morethegr8/Dishwasher_Controller/hardware/README.md

# SCHEMATIC & HARDWARE 

| |
|---|
|Dishwasher||
|**DISHWASHER IO BOARD**||

Testing & Trial carried out at Raddisson Hotel, Goregoan --> https://www.youtube.com/watch?v=VfFnfKIvYKQ
