morethegr8/Dishwasher_Controller/hardware/IO.pdf

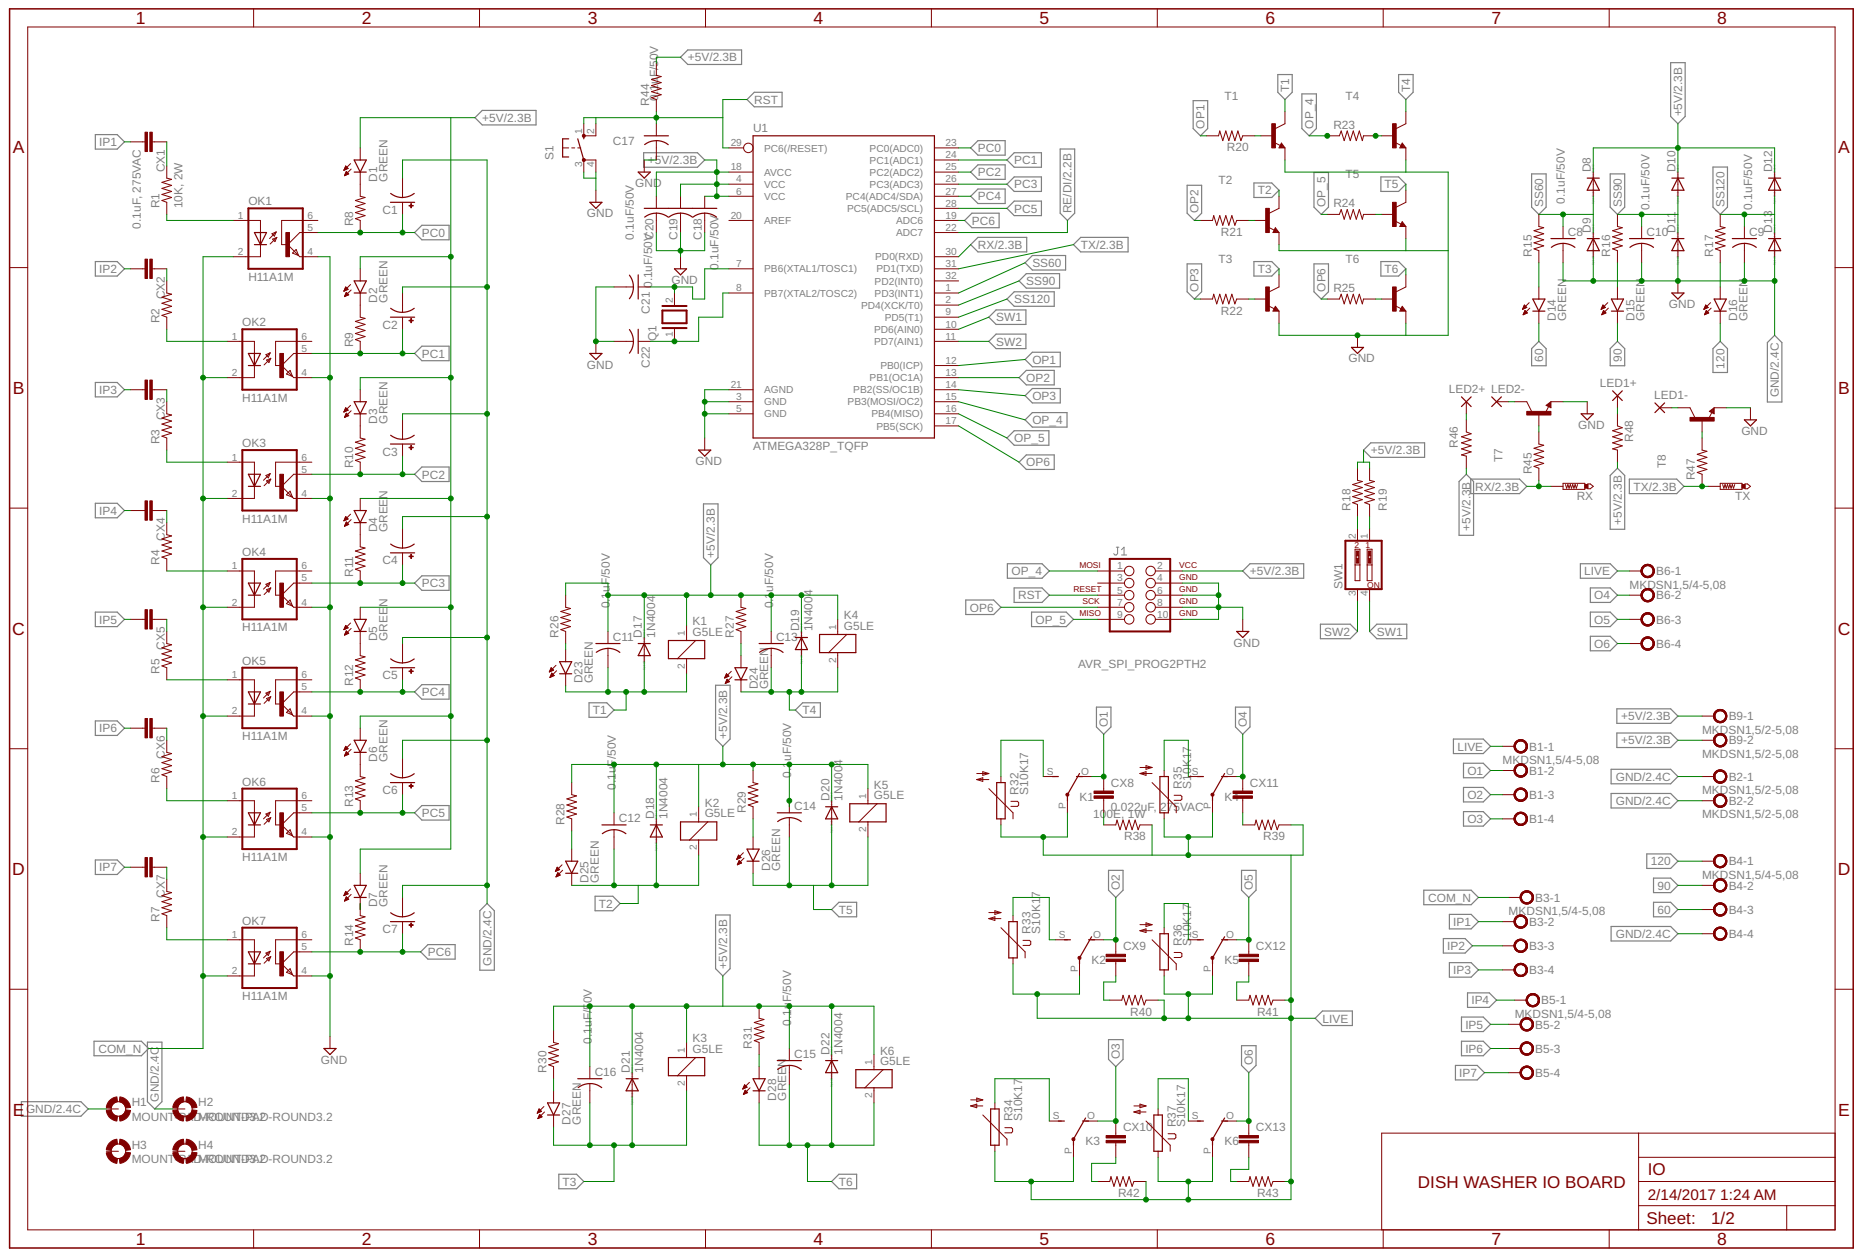
[picture p1: page 1]

GREEN GREEN GREEN GREEN GREEN GREEN GREEN

SpiceOrder 1 SpiceOrder 2

2 1ON MOSI RESET SCK MISO

VCC GND GND GND GND

DISH WASHER IO BOARD

Sheet: 1/2
