morethegr8/Dishwasher_Controller/hardware/IO.sch

## EAGLE design hardware/IO.sch (2018-12-08)

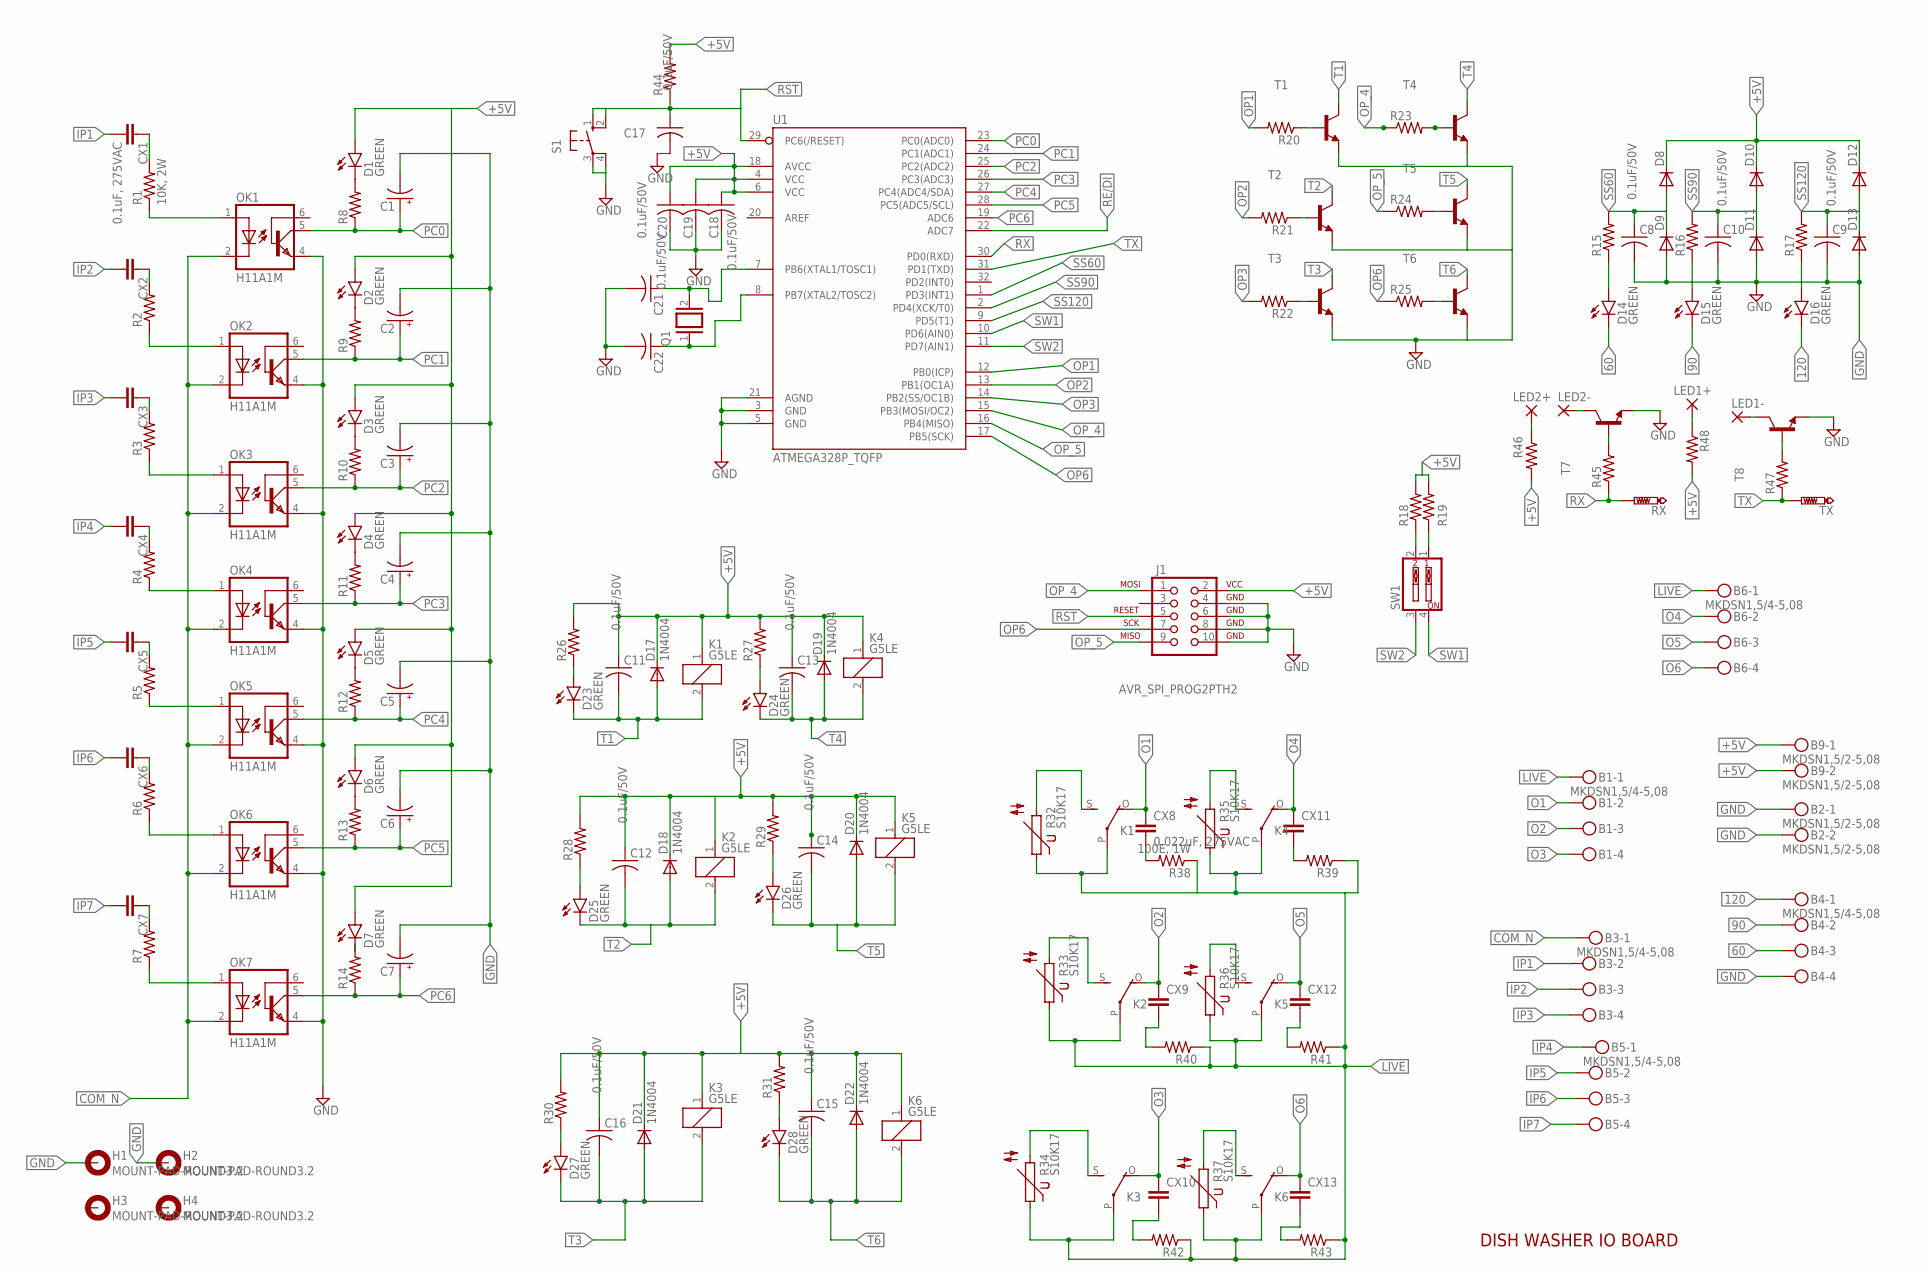
[picture p2: schematic IO.sch, sheet 1]

Parts:
B1, B3, B4, B5, B6: MKDSN1,5/4-5,08
B2, B9: MKDSN1,5/2-5,08
C1, C2, C3, C4, C5, C6, C7: CPOL-USSMCC; SMC_C
C8, C9, C10, C11, C12, C13, C14, C15, C16, C17, C18, C19, C20: 0.1uF/50V; C0805K
C21, C22: C-USC0603K; C0603K
CX1: 0.1uF, 275VAC; XC15B8
CX2, CX3, CX4, CX5, CX6, CX7: CXXC15B8; XC15B8
CX8: 0.022uF, 275VAC; XC10B5
CX9, CX10, CX11, CX12, CX13: CXXC10B5; XC10B5
D1, D2, D3, D4, D5, D6, D7, D14, D15, D16, D23, D24, D25, D26, D27, D28: GREEN; LED-1206
D8, D9, D10, D11, D12, D13: 1N4148DO35-10; DO35-10
D17, D18, D19, D20, D21, D22: 1N4004; DO41-10
H1, H2, H3, H4: MOUNT-PAD-ROUND3.2; 3,2-PAD
J1: AVR_SPI_PROG2PTH2; 2X5-SHROUDED
K1, K2, K3, K4, K5, K6: G5LE
LED1+, LED1-, LED2+, LED2-: 2,54/1,0
OK1, OK2, OK3, OK4, OK5, OK6, OK7: H11A1M; DIL06
Q1: XTAL/S; QS
R1: 10K, 2W; 0617/22
R2, R3, R4, R5, R6, R7: R-US_0617/22; 0617/22
R8, R9, R10, R11, R12, R13, R14, R15, R16, R17, R18, R19, R20, R21, R22, R23, R24, R25, R26, R27, R28, R29, R30, R31, R44, R45, R46, R47, R48: R-US_R0805; R0805
R32, R33, R34, R35, R36, R37: S10K17
R38: 100E, 1W; 0411/15
R39, R40, R41, R42, R43: R-US_0411/15; 0411/15
RX: PTR1B1,27; B1,27
S1: 10-XX; B3F-10XX
SW1: SW_DIP-2; EDG-02
T1, T2, T3, T4, T5, T6, T7, T8: MMBT2222ALT1-NPN-SOT23-BEC; SOT23-BEC
TX: PTR1B1,27; B1,27
U1: ATMEGA328P_TQFP; TQFP32-08

Connections:
60: B4.3, D14.C
90: B4.2, D15.C
120: B4.1, D16.C
+5V: B9.1, B9.2, C11.1, C12.1, C13.1, C14.1, C15.1, C16.1, C18.1, C19.1, C20.1, D1.A, D2.A, D3.A, D4.A, D5.A, D6.A, D7.A, D8.C, D10.C, D12.C, D17.C, D18.C, D19.C, D20.C, D21.C, D22.C, J1.2 (VCC), K1.1, K2.1, K3.1, K4.1, K5.1, K6.1, R18.2, R19.2, R26.2, R27.2, R28.2, R29.2, R30.2, R31.2, R44.2, R46.2, R48.2, U1.4 (VCC), U1.6 (VCC), U1.18 (AVCC)
COM_N: B3.1, OK1.2 (C), OK2.2 (C), OK3.2 (C), OK4.2 (C), OK5.2 (C), OK6.2 (C), OK7.2 (C)
GND: B2.1, B2.2, B4.4, C1.-, C2.-, C3.-, C4.-, C5.-, C6.-, C7.-, C8.2, C9.2, C10.2, C17.2, C18.2, C19.2, C20.2, C21.2, C22.2, D9.A, D11.A, D13.A, H1.B3,2, H2.B3,2, J1.4 (GND), J1.6 (GND), J1.8 (GND), J1.10 (GND), OK1.4 (EMI), OK2.4 (EMI), OK3.4 (EMI), OK4.4 (EMI), OK5.4 (EMI), OK6.4 (EMI), OK7.4 (EMI), S1.3, S1.4 (P1), T1.E, T2.E, T3.E, T4.E, T5.E, T6.E, T7.E, T8.E, U1.3 (GND), U1.5 (GND), U1.21 (AGND)
IP1: B3.2, CX1.2
IP2: B3.3, CX2.2
IP3: B3.4, CX3.2
IP4: B5.1, CX4.2
IP5: B5.2, CX5.2
IP6: B5.3, CX6.2
IP7: B5.4, CX7.2
LIVE: B1.1, B6.1, K1.P, K2.P, K3.P, K4.P, K5.P, K6.P, R32.1, R33.1, R34.1, R35.1, R36.1, R37.1, R38.1, R39.1, R40.1, R41.1, R42.1, R43.1
unnamed: OK1.1 (A), R1.1
unnamed: CX1.1, R1.2
unnamed: CX2.1, R2.2
unnamed: OK2.1 (A), R2.1
unnamed: CX3.1, R3.2
unnamed: OK3.1 (A), R3.1
unnamed: CX4.1, R4.2
unnamed: OK4.1 (A), R4.1
unnamed: CX5.1, R5.2
unnamed: CX6.1, R6.2
unnamed: OK5.1 (A), R5.1
unnamed: OK6.1 (A), R6.1
unnamed: CX7.1, R7.2
unnamed: OK7.1 (A), R7.1
unnamed: D1.C, R8.2
unnamed: D2.C, R9.2
unnamed: D3.C, R10.2
unnamed: D4.C, R11.2
unnamed: D5.C, R12.2
unnamed: D6.C, R13.2
unnamed: D7.C, R14.2
unnamed: R45.2, T7.B
unnamed: R47.2, T8.B
unnamed: R20.1, T1.B
unnamed: LED2+.1, R46.1
unnamed: R18.1, SW1.2
unnamed: R19.1, SW1.1
unnamed: R21.1, T2.B
unnamed: D14.A, R15.1
unnamed: D15.A, R16.1
unnamed: D16.A, R17.1
unnamed: R22.1, T3.B
unnamed: R23.2, T4.B
unnamed: R24.2, T5.B
unnamed: R25.2, T6.B
unnamed: LED2-.1, T7.C
unnamed: D27.A, R30.1
unnamed: D23.A, R26.1
unnamed: K1.S, R32.2
unnamed: CX8.2, R38.2
unnamed: D24.A, R27.1
unnamed: D26.A, R29.1
unnamed: D25.A, R28.1
unnamed: K4.S, R35.2
unnamed: CX11.2, R39.2
unnamed: K2.S, R33.2
unnamed: D28.A, R31.1
unnamed: CX9.2, R40.2
unnamed: CX12.2, R41.2
unnamed: K5.S, R36.2
unnamed: CX10.2, R42.2
unnamed: K3.S, R34.2
unnamed: CX13.2, R43.2
unnamed: K6.S, R37.2
unnamed: C21.1, Q1.2, U1.7 (PB6(XTAL1/TOSC1))
unnamed: LED1+.1, R48.1
unnamed: C22.1, Q1.1, U1.8 (PB7(XTAL2/TOSC2))
unnamed: LED1-.1, T8.C
O1: B1.2, CX8.1, K1.O
O2: B1.3, CX9.1, K2.O
O3: B1.4, CX10.1, K3.O
O4: B6.2, CX11.1, K4.O
O5: B6.3, CX12.1, K5.O
O6: B6.4, CX13.1, K6.O
OP1: R20.2, U1.12 (PB0(ICP))
OP2: R21.2, U1.13 (PB1(OC1A))
OP3: R22.2, U1.14 (PB2(SS/OC1B))
OP6: J1.7 (SCK), R25.1, U1.17 (PB5(SCK))
OP_4: J1.1 (MOSI), R23.1, U1.15 (PB3(MOSI/OC2))
OP_5: J1.9 (MISO), R24.1, U1.16 (PB4(MISO))
PC0: C1.+, OK1.5 (COL), R8.1, U1.23 (PC0(ADC0))
PC1: C2.+, OK2.5 (COL), R9.1, U1.24 (PC1(ADC1))
PC2: C3.+, OK3.5 (COL), R10.1, U1.25 (PC2(ADC2))
PC3: C4.+, OK4.5 (COL), R11.1, U1.26 (PC3(ADC3))
PC4: C5.+, OK5.5 (COL), R12.1, U1.27 (PC4(ADC4/SDA))
PC5: C6.+, OK6.5 (COL), R13.1, U1.28 (PC5(ADC5/SCL))
PC6: C7.+, OK7.5 (COL), R14.1, U1.19 (ADC6)
RE/DI: U1.22 (ADC7)
RST: C17.1, J1.5 (RESET), R44.1, S1.1 (S), S1.2 (S1), U1.29 (PC6(/RESET))
RX: R45.1, RX.TP, U1.30 (PD0(RXD))
SS60: C8.1, D8.A, D9.C, R15.2, U1.1 (PD3(INT1))
SS90: C10.1, D10.A, D11.C, R16.2, U1.2 (PD4(XCK/T0))
SS120: C9.1, D12.A, D13.C, R17.2, U1.9 (PD5(T1))
SW1: SW1.4, U1.10 (PD6(AIN0))
SW2: SW1.3, U1.11 (PD7(AIN1))
T1: C11.2, D17.A, D23.C, K1.2, T1.C
T2: C12.2, D18.A, D25.C, K2.2, T2.C
T3: C16.2, D21.A, D27.C, K3.2, T3.C
T4: C13.2, D19.A, D24.C, K4.2, T4.C
T5: C14.2, D20.A, D26.C, K5.2, T5.C
T6: C15.2, D22.A, D28.C, K6.2, T6.C
TX: R47.1, TX.TP, U1.31 (PD1(TXD))

Notes on the sheet:
DISH WASHER IO BOARD

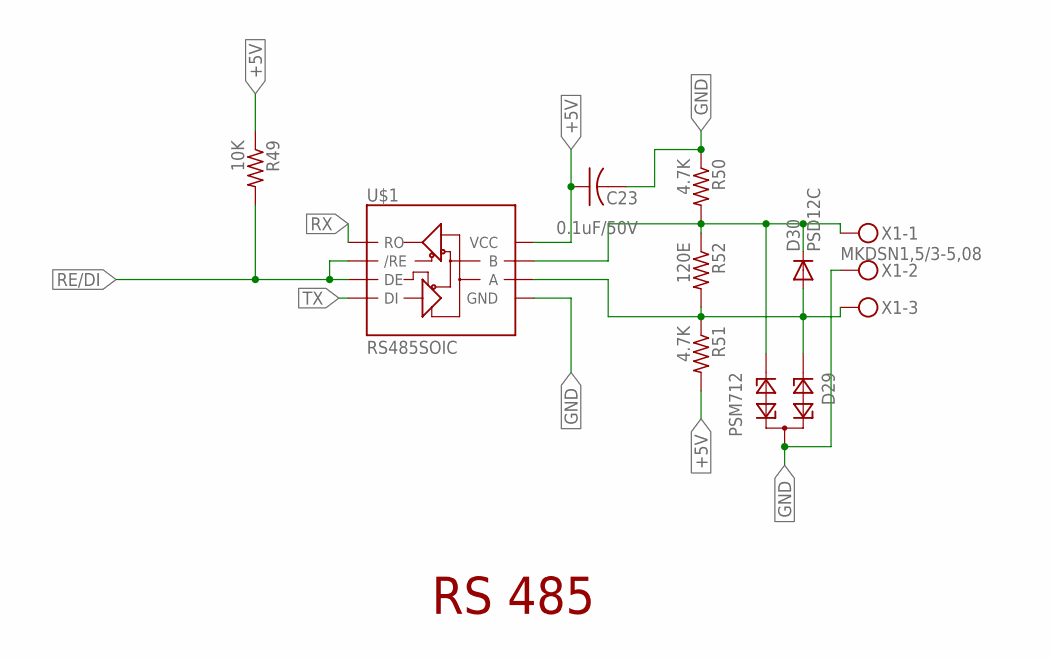
[picture p3: schematic IO.sch, sheet 2]

Parts:
C23: 0.1uF/50V; C0805K
D29: PSM712; SOT23
D30: PSD12C; SMA
R49: 10K; R0603
R50, R51: 4.7K; R0603
R52: 120E; R0805
U$1: RS485SOIC; SO08
X1: MKDSN1,5/3-5,08

Connections:
+5V: C23.1, R49.1, R51.2, U$1.8 (VCC)
GND: C23.2, D29.3, R50.1, U$1.5 (GND), X1.2
unnamed: D29.2, D30.C, R50.2, R52.1, U$1.7 (B), X1.1
unnamed: D29.1, D30.A, R51.1, R52.2, U$1.6 (A), X1.3
RE/DI: R49.2, U$1.2 (/RE), U$1.3 (DE)
RX: U$1.1 (RO)
TX: U$1.4 (DI)

Notes on the sheet:
RS 485
