morethegr8/Dishwasher_Controller/code/src/driver_init.c

/**
 * \file
 *
 * \brief Driver initialization.
 *
 *
 * Copyright (C) 2016 Atmel Corporation. All rights reserved.
 *
 * \asf_license_start
 *
 * \page License
 *
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
 * 3. The name of Atmel may not be used to endorse or promote products derived
 *    from this software without specific prior written permission.
 *
 * 4. This software may only be redistributed and used in connection with an
 *    Atmel microcontroller product.
 *
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
 * \asf_license_stop
 *
 *
 */

/*
 * Code generated by START.
 *
 * This file will be overwritten when reconfiguring your START project.
 * Please copy examples or other code you want to keep to a separate file
 * to avoid losing it when reconfiguring.
 */

#include "driver_init.h"
#include <system.h>

void TIMER_0_initialization(void)
{

	TIMER_0_init();
}

/* configure pins and initialize registers */
void USART_0_initialization(void)
{

	// Set pin direction to input
	PD0_set_dir(PORT_DIR_IN);

	PD0_set_pull_mode(
	    // <y> Pull configuration
	    // <id> pad_pull_config
	    // <PORT_PULL_OFF"> Off
	    // <PORT_PULL_UP"> Pull-up
	    PORT_PULL_OFF);

	// Set pin direction to output
	PD1_set_dir(PORT_DIR_OUT);

	PD1_set_level(
	    // <y> Initial level
	    // <id> pad_initial_level
	    // <false"> Low
	    // <true"> High
	    false);

	USART_0_init();
}

void system_init()
{
	mcu_init();

	/* PORT setting on PB0 */

	// Set pin direction to output
	Wash_Pump_set_dir(PORT_DIR_OUT);

	Wash_Pump_set_level(
	    // <y> Initial level
	    // <id> pad_initial_level
	    // <false"> Low
	    // <true"> High
	    false);

	/* PORT setting on PB1 */

	// Set pin direction to output
	Rinse_Pump_set_dir(PORT_DIR_OUT);

	Rinse_Pump_set_level(
	    // <y> Initial level
	    // <id> pad_initial_level
	    // <false"> Low
	    // <true"> High
	    false);

	/* PORT setting on PB2 */

	// Set pin direction to output
	Fill_set_dir(PORT_DIR_OUT);

	Fill_set_level(
	    // <y> Initial level
	    // <id> pad_initial_level
	    // <false"> Low
	    // <true"> High
	    false);

	/* PORT setting on PB3 */

	// Set pin direction to output
	Tank_Heater_set_dir(PORT_DIR_OUT);

	Tank_Heater_set_level(
	    // <y> Initial level
	    // <id> pad_initial_level
	    // <false"> Low
	    // <true"> High
	    false);

	/* PORT setting on PB4 */

	// Set pin direction to output
	Bst_Heater_set_dir(PORT_DIR_OUT);

	Bst_Heater_set_level(
	    // <y> Initial level
	    // <id> pad_initial_level
	    // <false"> Low
	    // <true"> High
	    false);

	/* PORT setting on PB5 */

	// Set pin direction to output
	Indicator_set_dir(PORT_DIR_OUT);

	Indicator_set_level(
	    // <y> Initial level
	    // <id> pad_initial_level
	    // <false"> Low
	    // <true"> High
	    false);

	/* PORT setting on PC0 */

	// Set pin direction to input
	DoorSw_set_dir(PORT_DIR_IN);

	DoorSw_set_pull_mode(
	    // <y> Pull configuration
	    // <id> pad_pull_config
	    // <PORT_PULL_OFF"> Off
	    // <PORT_PULL_UP"> Pull-up
	    PORT_PULL_OFF);

	/* PORT setting on PC1 */

	// Set pin direction to input
	TankLL_set_dir(PORT_DIR_IN);

	TankLL_set_pull_mode(
	    // <y> Pull configuration
	    // <id> pad_pull_config
	    // <PORT_PULL_OFF"> Off
	    // <PORT_PULL_UP"> Pull-up
	    PORT_PULL_OFF);

	/* PORT setting on PC2 */

	// Set pin direction to input
	TankHL_set_dir(PORT_DIR_IN);

	TankHL_set_pull_mode(
	    // <y> Pull configuration
	    // <id> pad_pull_config
	    // <PORT_PULL_OFF"> Off
	    // <PORT_PULL_UP"> Pull-up
	    PORT_PULL_OFF);

	/* PORT setting on PC3 */

	// Set pin direction to input
	Bst_temp_set_dir(PORT_DIR_IN);

	Bst_temp_set_pull_mode(
	    // <y> Pull configuration
	    // <id> pad_pull_config
	    // <PORT_PULL_OFF"> Off
	    // <PORT_PULL_UP"> Pull-up
	    PORT_PULL_OFF);

	/* PORT setting on PC4 */

	// Set pin direction to input
	Bst_LL_set_dir(PORT_DIR_IN);

	Bst_LL_set_pull_mode(
	    // <y> Pull configuration
	    // <id> pad_pull_config
	    // <PORT_PULL_OFF"> Off
	    // <PORT_PULL_UP"> Pull-up
	    PORT_PULL_OFF);

	/* PORT setting on PC5 */

	// Set pin direction to input
	Bst_HL_set_dir(PORT_DIR_IN);

	Bst_HL_set_pull_mode(
	    // <y> Pull configuration
	    // <id> pad_pull_config
	    // <PORT_PULL_OFF"> Off
	    // <PORT_PULL_UP"> Pull-up
	    PORT_PULL_OFF);

	/* PORT setting on PC6 */

	// Set pin direction to input
	Usr_def_set_dir(PORT_DIR_IN);

	Usr_def_set_pull_mode(
	    // <y> Pull configuration
	    // <id> pad_pull_config
	    // <PORT_PULL_OFF"> Off
	    // <PORT_PULL_UP"> Pull-up
	    PORT_PULL_OFF);

	/* PORT setting on PD3 */

	// Set pin direction to input
	SS60_set_dir(PORT_DIR_IN);

	SS60_set_pull_mode(
	    // <y> Pull configuration
	    // <id> pad_pull_config
	    // <PORT_PULL_OFF"> Off
	    // <PORT_PULL_UP"> Pull-up
	    PORT_PULL_UP);

	/* PORT setting on PD4 */

	// Set pin direction to input
	SS90_set_dir(PORT_DIR_IN);

	SS90_set_pull_mode(
	    // <y> Pull configuration
	    // <id> pad_pull_config
	    // <PORT_PULL_OFF"> Off
	    // <PORT_PULL_UP"> Pull-up
	    PORT_PULL_UP);

	/* PORT setting on PD5 */

	// Set pin direction to input
	SS120_set_dir(PORT_DIR_IN);

	SS120_set_pull_mode(
	    // <y> Pull configuration
	    // <id> pad_pull_config
	    // <PORT_PULL_OFF"> Off
	    // <PORT_PULL_UP"> Pull-up
	    PORT_PULL_UP);

	/* PORT setting on PD6 */

	// Set pin direction to input
	DIPSW1_set_dir(PORT_DIR_IN);

	DIPSW1_set_pull_mode(
	    // <y> Pull configuration
	    // <id> pad_pull_config
	    // <PORT_PULL_OFF"> Off
	    // <PORT_PULL_UP"> Pull-up
	    PORT_PULL_OFF);

	/* PORT setting on PD7 */

	// Set pin direction to input
	DIPSW2_set_dir(PORT_DIR_IN);

	DIPSW2_set_pull_mode(
	    // <y> Pull configuration
	    // <id> pad_pull_config
	    // <PORT_PULL_OFF"> Off
	    // <PORT_PULL_UP"> Pull-up
	    PORT_PULL_OFF);

	sysctrl_init();

	WDT_0_init();

	TIMER_0_initialization();

	USART_0_initialization();
}
