morethegr8/Dishwasher_Controller/code/include/atmel_start_pins.h

/*
 * Code generated from Atmel Start.
 *
 * This file will be overwritten when reconfiguring your Atmel Start project.
 * Please copy examples or other code you want to keep to a separate file
 * to avoid losing it when reconfiguring.
 */
#ifndef ATMEL_START_PINS_H_INCLUDED
#define ATMEL_START_PINS_H_INCLUDED

#include <port.h>

/**
 * \brief Set Wash_Pump pull mode
 *
 * Configure pin to pull up, down or disable pull mode, supported pull
 * modes are defined by device used
 *
 * \param[in] pull_mode Pin pull mode
 */
static inline void Wash_Pump_set_pull_mode(const enum port_pull_mode pull_mode)
{
	PORTB_set_pin_pull_mode(0, pull_mode);
}

/**
 * \brief Set Wash_Pump data direction
 *
 * Select if the pin data direction is input, output or disabled.
 * If disabled state is not possible, this function throws an assert.
 *
 * \param[in] direction PORT_DIR_IN  = Data direction in
 *                      PORT_DIR_OUT = Data direction out
 *                      PORT_DIR_OFF = Disables the pin
 *                      (low power state)
 */
static inline void Wash_Pump_set_dir(const enum port_dir dir)
{
	PORTB_set_pin_dir(0, dir);
}

/**
 * \brief Set Wash_Pump level
 *
 * Sets output level on a pin
 *
 * \param[in] level true  = Pin level set to "high" state
 *                  false = Pin level set to "low" state
 */
static inline void Wash_Pump_set_level(const bool level)
{
	PORTB_set_pin_level(0, level);
}

/**
 * \brief Toggle output level on Wash_Pump
 *
 * Toggle the pin level
 */
static inline void Wash_Pump_toggle_level()
{
	PORTB_toggle_pin_level(0);
}

/**
 * \brief Get level on Wash_Pump
 *
 * Reads the level on a pin
 */
static inline bool Wash_Pump_get_level()
{
	return PORTB_get_pin_level(0);
}

/**
 * \brief Set Rinse_Pump pull mode
 *
 * Configure pin to pull up, down or disable pull mode, supported pull
 * modes are defined by device used
 *
 * \param[in] pull_mode Pin pull mode
 */
static inline void Rinse_Pump_set_pull_mode(const enum port_pull_mode pull_mode)
{
	PORTB_set_pin_pull_mode(1, pull_mode);
}

/**
 * \brief Set Rinse_Pump data direction
 *
 * Select if the pin data direction is input, output or disabled.
 * If disabled state is not possible, this function throws an assert.
 *
 * \param[in] direction PORT_DIR_IN  = Data direction in
 *                      PORT_DIR_OUT = Data direction out
 *                      PORT_DIR_OFF = Disables the pin
 *                      (low power state)
 */
static inline void Rinse_Pump_set_dir(const enum port_dir dir)
{
	PORTB_set_pin_dir(1, dir);
}

/**
 * \brief Set Rinse_Pump level
 *
 * Sets output level on a pin
 *
 * \param[in] level true  = Pin level set to "high" state
 *                  false = Pin level set to "low" state
 */
static inline void Rinse_Pump_set_level(const bool level)
{
	PORTB_set_pin_level(1, level);
}

/**
 * \brief Toggle output level on Rinse_Pump
 *
 * Toggle the pin level
 */
static inline void Rinse_Pump_toggle_level()
{
	PORTB_toggle_pin_level(1);
}

/**
 * \brief Get level on Rinse_Pump
 *
 * Reads the level on a pin
 */
static inline bool Rinse_Pump_get_level()
{
	return PORTB_get_pin_level(1);
}

/**
 * \brief Set Fill pull mode
 *
 * Configure pin to pull up, down or disable pull mode, supported pull
 * modes are defined by device used
 *
 * \param[in] pull_mode Pin pull mode
 */
static inline void Fill_set_pull_mode(const enum port_pull_mode pull_mode)
{
	PORTB_set_pin_pull_mode(2, pull_mode);
}

/**
 * \brief Set Fill data direction
 *
 * Select if the pin data direction is input, output or disabled.
 * If disabled state is not possible, this function throws an assert.
 *
 * \param[in] direction PORT_DIR_IN  = Data direction in
 *                      PORT_DIR_OUT = Data direction out
 *                      PORT_DIR_OFF = Disables the pin
 *                      (low power state)
 */
static inline void Fill_set_dir(const enum port_dir dir)
{
	PORTB_set_pin_dir(2, dir);
}

/**
 * \brief Set Fill level
 *
 * Sets output level on a pin
 *
 * \param[in] level true  = Pin level set to "high" state
 *                  false = Pin level set to "low" state
 */
static inline void Fill_set_level(const bool level)
{
	PORTB_set_pin_level(2, level);
}

/**
 * \brief Toggle output level on Fill
 *
 * Toggle the pin level
 */
static inline void Fill_toggle_level()
{
	PORTB_toggle_pin_level(2);
}

/**
 * \brief Get level on Fill
 *
 * Reads the level on a pin
 */
static inline bool Fill_get_level()
{
	return PORTB_get_pin_level(2);
}

/**
 * \brief Set Tank_Heater pull mode
 *
 * Configure pin to pull up, down or disable pull mode, supported pull
 * modes are defined by device used
 *
 * \param[in] pull_mode Pin pull mode
 */
static inline void Tank_Heater_set_pull_mode(const enum port_pull_mode pull_mode)
{
	PORTB_set_pin_pull_mode(3, pull_mode);
}

/**
 * \brief Set Tank_Heater data direction
 *
 * Select if the pin data direction is input, output or disabled.
 * If disabled state is not possible, this function throws an assert.
 *
 * \param[in] direction PORT_DIR_IN  = Data direction in
 *                      PORT_DIR_OUT = Data direction out
 *                      PORT_DIR_OFF = Disables the pin
 *                      (low power state)
 */
static inline void Tank_Heater_set_dir(const enum port_dir dir)
{
	PORTB_set_pin_dir(3, dir);
}

/**
 * \brief Set Tank_Heater level
 *
 * Sets output level on a pin
 *
 * \param[in] level true  = Pin level set to "high" state
 *                  false = Pin level set to "low" state
 */
static inline void Tank_Heater_set_level(const bool level)
{
	PORTB_set_pin_level(3, level);
}

/**
 * \brief Toggle output level on Tank_Heater
 *
 * Toggle the pin level
 */
static inline void Tank_Heater_toggle_level()
{
	PORTB_toggle_pin_level(3);
}

/**
 * \brief Get level on Tank_Heater
 *
 * Reads the level on a pin
 */
static inline bool Tank_Heater_get_level()
{
	return PORTB_get_pin_level(3);
}

/**
 * \brief Set Bst_Heater pull mode
 *
 * Configure pin to pull up, down or disable pull mode, supported pull
 * modes are defined by device used
 *
 * \param[in] pull_mode Pin pull mode
 */
static inline void Bst_Heater_set_pull_mode(const enum port_pull_mode pull_mode)
{
	PORTB_set_pin_pull_mode(4, pull_mode);
}

/**
 * \brief Set Bst_Heater data direction
 *
 * Select if the pin data direction is input, output or disabled.
 * If disabled state is not possible, this function throws an assert.
 *
 * \param[in] direction PORT_DIR_IN  = Data direction in
 *                      PORT_DIR_OUT = Data direction out
 *                      PORT_DIR_OFF = Disables the pin
 *                      (low power state)
 */
static inline void Bst_Heater_set_dir(const enum port_dir dir)
{
	PORTB_set_pin_dir(4, dir);
}

/**
 * \brief Set Bst_Heater level
 *
 * Sets output level on a pin
 *
 * \param[in] level true  = Pin level set to "high" state
 *                  false = Pin level set to "low" state
 */
static inline void Bst_Heater_set_level(const bool level)
{
	PORTB_set_pin_level(4, level);
}

/**
 * \brief Toggle output level on Bst_Heater
 *
 * Toggle the pin level
 */
static inline void Bst_Heater_toggle_level()
{
	PORTB_toggle_pin_level(4);
}

/**
 * \brief Get level on Bst_Heater
 *
 * Reads the level on a pin
 */
static inline bool Bst_Heater_get_level()
{
	return PORTB_get_pin_level(4);
}

/**
 * \brief Set Indicator pull mode
 *
 * Configure pin to pull up, down or disable pull mode, supported pull
 * modes are defined by device used
 *
 * \param[in] pull_mode Pin pull mode
 */
static inline void Indicator_set_pull_mode(const enum port_pull_mode pull_mode)
{
	PORTB_set_pin_pull_mode(5, pull_mode);
}

/**
 * \brief Set Indicator data direction
 *
 * Select if the pin data direction is input, output or disabled.
 * If disabled state is not possible, this function throws an assert.
 *
 * \param[in] direction PORT_DIR_IN  = Data direction in
 *                      PORT_DIR_OUT = Data direction out
 *                      PORT_DIR_OFF = Disables the pin
 *                      (low power state)
 */
static inline void Indicator_set_dir(const enum port_dir dir)
{
	PORTB_set_pin_dir(5, dir);
}

/**
 * \brief Set Indicator level
 *
 * Sets output level on a pin
 *
 * \param[in] level true  = Pin level set to "high" state
 *                  false = Pin level set to "low" state
 */
static inline void Indicator_set_level(const bool level)
{
	PORTB_set_pin_level(5, level);
}

/**
 * \brief Toggle output level on Indicator
 *
 * Toggle the pin level
 */
static inline void Indicator_toggle_level()
{
	PORTB_toggle_pin_level(5);
}

/**
 * \brief Get level on Indicator
 *
 * Reads the level on a pin
 */
static inline bool Indicator_get_level()
{
	return PORTB_get_pin_level(5);
}

/**
 * \brief Set DoorSw pull mode
 *
 * Configure pin to pull up, down or disable pull mode, supported pull
 * modes are defined by device used
 *
 * \param[in] pull_mode Pin pull mode
 */
static inline void DoorSw_set_pull_mode(const enum port_pull_mode pull_mode)
{
	PORTC_set_pin_pull_mode(0, pull_mode);
}

/**
 * \brief Set DoorSw data direction
 *
 * Select if the pin data direction is input, output or disabled.
 * If disabled state is not possible, this function throws an assert.
 *
 * \param[in] direction PORT_DIR_IN  = Data direction in
 *                      PORT_DIR_OUT = Data direction out
 *                      PORT_DIR_OFF = Disables the pin
 *                      (low power state)
 */
static inline void DoorSw_set_dir(const enum port_dir dir)
{
	PORTC_set_pin_dir(0, dir);
}

/**
 * \brief Set DoorSw level
 *
 * Sets output level on a pin
 *
 * \param[in] level true  = Pin level set to "high" state
 *                  false = Pin level set to "low" state
 */
static inline void DoorSw_set_level(const bool level)
{
	PORTC_set_pin_level(0, level);
}

/**
 * \brief Toggle output level on DoorSw
 *
 * Toggle the pin level
 */
static inline void DoorSw_toggle_level()
{
	PORTC_toggle_pin_level(0);
}

/**
 * \brief Get level on DoorSw
 *
 * Reads the level on a pin
 */
static inline bool DoorSw_get_level()
{
	return PORTC_get_pin_level(0);
}

/**
 * \brief Set TankLL pull mode
 *
 * Configure pin to pull up, down or disable pull mode, supported pull
 * modes are defined by device used
 *
 * \param[in] pull_mode Pin pull mode
 */
static inline void TankLL_set_pull_mode(const enum port_pull_mode pull_mode)
{
	PORTC_set_pin_pull_mode(1, pull_mode);
}

/**
 * \brief Set TankLL data direction
 *
 * Select if the pin data direction is input, output or disabled.
 * If disabled state is not possible, this function throws an assert.
 *
 * \param[in] direction PORT_DIR_IN  = Data direction in
 *                      PORT_DIR_OUT = Data direction out
 *                      PORT_DIR_OFF = Disables the pin
 *                      (low power state)
 */
static inline void TankLL_set_dir(const enum port_dir dir)
{
	PORTC_set_pin_dir(1, dir);
}

/**
 * \brief Set TankLL level
 *
 * Sets output level on a pin
 *
 * \param[in] level true  = Pin level set to "high" state
 *                  false = Pin level set to "low" state
 */
static inline void TankLL_set_level(const bool level)
{
	PORTC_set_pin_level(1, level);
}

/**
 * \brief Toggle output level on TankLL
 *
 * Toggle the pin level
 */
static inline void TankLL_toggle_level()
{
	PORTC_toggle_pin_level(1);
}

/**
 * \brief Get level on TankLL
 *
 * Reads the level on a pin
 */
static inline bool TankLL_get_level()
{
	return PORTC_get_pin_level(1);
}

/**
 * \brief Set TankHL pull mode
 *
 * Configure pin to pull up, down or disable pull mode, supported pull
 * modes are defined by device used
 *
 * \param[in] pull_mode Pin pull mode
 */
static inline void TankHL_set_pull_mode(const enum port_pull_mode pull_mode)
{
	PORTC_set_pin_pull_mode(2, pull_mode);
}

/**
 * \brief Set TankHL data direction
 *
 * Select if the pin data direction is input, output or disabled.
 * If disabled state is not possible, this function throws an assert.
 *
 * \param[in] direction PORT_DIR_IN  = Data direction in
 *                      PORT_DIR_OUT = Data direction out
 *                      PORT_DIR_OFF = Disables the pin
 *                      (low power state)
 */
static inline void TankHL_set_dir(const enum port_dir dir)
{
	PORTC_set_pin_dir(2, dir);
}

/**
 * \brief Set TankHL level
 *
 * Sets output level on a pin
 *
 * \param[in] level true  = Pin level set to "high" state
 *                  false = Pin level set to "low" state
 */
static inline void TankHL_set_level(const bool level)
{
	PORTC_set_pin_level(2, level);
}

/**
 * \brief Toggle output level on TankHL
 *
 * Toggle the pin level
 */
static inline void TankHL_toggle_level()
{
	PORTC_toggle_pin_level(2);
}

/**
 * \brief Get level on TankHL
 *
 * Reads the level on a pin
 */
static inline bool TankHL_get_level()
{
	return PORTC_get_pin_level(2);
}

/**
 * \brief Set Bst_temp pull mode
 *
 * Configure pin to pull up, down or disable pull mode, supported pull
 * modes are defined by device used
 *
 * \param[in] pull_mode Pin pull mode
 */
static inline void Bst_temp_set_pull_mode(const enum port_pull_mode pull_mode)
{
	PORTC_set_pin_pull_mode(3, pull_mode);
}

/**
 * \brief Set Bst_temp data direction
 *
 * Select if the pin data direction is input, output or disabled.
 * If disabled state is not possible, this function throws an assert.
 *
 * \param[in] direction PORT_DIR_IN  = Data direction in
 *                      PORT_DIR_OUT = Data direction out
 *                      PORT_DIR_OFF = Disables the pin
 *                      (low power state)
 */
static inline void Bst_temp_set_dir(const enum port_dir dir)
{
	PORTC_set_pin_dir(3, dir);
}

/**
 * \brief Set Bst_temp level
 *
 * Sets output level on a pin
 *
 * \param[in] level true  = Pin level set to "high" state
 *                  false = Pin level set to "low" state
 */
static inline void Bst_temp_set_level(const bool level)
{
	PORTC_set_pin_level(3, level);
}

/**
 * \brief Toggle output level on Bst_temp
 *
 * Toggle the pin level
 */
static inline void Bst_temp_toggle_level()
{
	PORTC_toggle_pin_level(3);
}

/**
 * \brief Get level on Bst_temp
 *
 * Reads the level on a pin
 */
static inline bool Bst_temp_get_level()
{
	return PORTC_get_pin_level(3);
}

/**
 * \brief Set Bst_LL pull mode
 *
 * Configure pin to pull up, down or disable pull mode, supported pull
 * modes are defined by device used
 *
 * \param[in] pull_mode Pin pull mode
 */
static inline void Bst_LL_set_pull_mode(const enum port_pull_mode pull_mode)
{
	PORTC_set_pin_pull_mode(4, pull_mode);
}

/**
 * \brief Set Bst_LL data direction
 *
 * Select if the pin data direction is input, output or disabled.
 * If disabled state is not possible, this function throws an assert.
 *
 * \param[in] direction PORT_DIR_IN  = Data direction in
 *                      PORT_DIR_OUT = Data direction out
 *                      PORT_DIR_OFF = Disables the pin
 *                      (low power state)
 */
static inline void Bst_LL_set_dir(const enum port_dir dir)
{
	PORTC_set_pin_dir(4, dir);
}

/**
 * \brief Set Bst_LL level
 *
 * Sets output level on a pin
 *
 * \param[in] level true  = Pin level set to "high" state
 *                  false = Pin level set to "low" state
 */
static inline void Bst_LL_set_level(const bool level)
{
	PORTC_set_pin_level(4, level);
}

/**
 * \brief Toggle output level on Bst_LL
 *
 * Toggle the pin level
 */
static inline void Bst_LL_toggle_level()
{
	PORTC_toggle_pin_level(4);
}

/**
 * \brief Get level on Bst_LL
 *
 * Reads the level on a pin
 */
static inline bool Bst_LL_get_level()
{
	return PORTC_get_pin_level(4);
}

/**
 * \brief Set Bst_HL pull mode
 *
 * Configure pin to pull up, down or disable pull mode, supported pull
 * modes are defined by device used
 *
 * \param[in] pull_mode Pin pull mode
 */
static inline void Bst_HL_set_pull_mode(const enum port_pull_mode pull_mode)
{
	PORTC_set_pin_pull_mode(5, pull_mode);
}

/**
 * \brief Set Bst_HL data direction
 *
 * Select if the pin data direction is input, output or disabled.
 * If disabled state is not possible, this function throws an assert.
 *
 * \param[in] direction PORT_DIR_IN  = Data direction in
 *                      PORT_DIR_OUT = Data direction out
 *                      PORT_DIR_OFF = Disables the pin
 *                      (low power state)
 */
static inline void Bst_HL_set_dir(const enum port_dir dir)
{
	PORTC_set_pin_dir(5, dir);
}

/**
 * \brief Set Bst_HL level
 *
 * Sets output level on a pin
 *
 * \param[in] level true  = Pin level set to "high" state
 *                  false = Pin level set to "low" state
 */
static inline void Bst_HL_set_level(const bool level)
{
	PORTC_set_pin_level(5, level);
}

/**
 * \brief Toggle output level on Bst_HL
 *
 * Toggle the pin level
 */
static inline void Bst_HL_toggle_level()
{
	PORTC_toggle_pin_level(5);
}

/**
 * \brief Get level on Bst_HL
 *
 * Reads the level on a pin
 */
static inline bool Bst_HL_get_level()
{
	return PORTC_get_pin_level(5);
}

/**
 * \brief Set Usr_def pull mode
 *
 * Configure pin to pull up, down or disable pull mode, supported pull
 * modes are defined by device used
 *
 * \param[in] pull_mode Pin pull mode
 */
static inline void Usr_def_set_pull_mode(const enum port_pull_mode pull_mode)
{
	PORTC_set_pin_pull_mode(6, pull_mode);
}

/**
 * \brief Set Usr_def data direction
 *
 * Select if the pin data direction is input, output or disabled.
 * If disabled state is not possible, this function throws an assert.
 *
 * \param[in] direction PORT_DIR_IN  = Data direction in
 *                      PORT_DIR_OUT = Data direction out
 *                      PORT_DIR_OFF = Disables the pin
 *                      (low power state)
 */
static inline void Usr_def_set_dir(const enum port_dir dir)
{
	PORTC_set_pin_dir(6, dir);
}

/**
 * \brief Set Usr_def level
 *
 * Sets output level on a pin
 *
 * \param[in] level true  = Pin level set to "high" state
 *                  false = Pin level set to "low" state
 */
static inline void Usr_def_set_level(const bool level)
{
	PORTC_set_pin_level(6, level);
}

/**
 * \brief Toggle output level on Usr_def
 *
 * Toggle the pin level
 */
static inline void Usr_def_toggle_level()
{
	PORTC_toggle_pin_level(6);
}

/**
 * \brief Get level on Usr_def
 *
 * Reads the level on a pin
 */
static inline bool Usr_def_get_level()
{
	return PORTC_get_pin_level(6);
}

/**
 * \brief Set PD0 pull mode
 *
 * Configure pin to pull up, down or disable pull mode, supported pull
 * modes are defined by device used
 *
 * \param[in] pull_mode Pin pull mode
 */
static inline void PD0_set_pull_mode(const enum port_pull_mode pull_mode)
{
	PORTD_set_pin_pull_mode(0, pull_mode);
}

/**
 * \brief Set PD0 data direction
 *
 * Select if the pin data direction is input, output or disabled.
 * If disabled state is not possible, this function throws an assert.
 *
 * \param[in] direction PORT_DIR_IN  = Data direction in
 *                      PORT_DIR_OUT = Data direction out
 *                      PORT_DIR_OFF = Disables the pin
 *                      (low power state)
 */
static inline void PD0_set_dir(const enum port_dir dir)
{
	PORTD_set_pin_dir(0, dir);
}

/**
 * \brief Set PD0 level
 *
 * Sets output level on a pin
 *
 * \param[in] level true  = Pin level set to "high" state
 *                  false = Pin level set to "low" state
 */
static inline void PD0_set_level(const bool level)
{
	PORTD_set_pin_level(0, level);
}

/**
 * \brief Toggle output level on PD0
 *
 * Toggle the pin level
 */
static inline void PD0_toggle_level()
{
	PORTD_toggle_pin_level(0);
}

/**
 * \brief Get level on PD0
 *
 * Reads the level on a pin
 */
static inline bool PD0_get_level()
{
	return PORTD_get_pin_level(0);
}

/**
 * \brief Set PD1 pull mode
 *
 * Configure pin to pull up, down or disable pull mode, supported pull
 * modes are defined by device used
 *
 * \param[in] pull_mode Pin pull mode
 */
static inline void PD1_set_pull_mode(const enum port_pull_mode pull_mode)
{
	PORTD_set_pin_pull_mode(1, pull_mode);
}

/**
 * \brief Set PD1 data direction
 *
 * Select if the pin data direction is input, output or disabled.
 * If disabled state is not possible, this function throws an assert.
 *
 * \param[in] direction PORT_DIR_IN  = Data direction in
 *                      PORT_DIR_OUT = Data direction out
 *                      PORT_DIR_OFF = Disables the pin
 *                      (low power state)
 */
static inline void PD1_set_dir(const enum port_dir dir)
{
	PORTD_set_pin_dir(1, dir);
}

/**
 * \brief Set PD1 level
 *
 * Sets output level on a pin
 *
 * \param[in] level true  = Pin level set to "high" state
 *                  false = Pin level set to "low" state
 */
static inline void PD1_set_level(const bool level)
{
	PORTD_set_pin_level(1, level);
}

/**
 * \brief Toggle output level on PD1
 *
 * Toggle the pin level
 */
static inline void PD1_toggle_level()
{
	PORTD_toggle_pin_level(1);
}

/**
 * \brief Get level on PD1
 *
 * Reads the level on a pin
 */
static inline bool PD1_get_level()
{
	return PORTD_get_pin_level(1);
}

/**
 * \brief Set SS60 pull mode
 *
 * Configure pin to pull up, down or disable pull mode, supported pull
 * modes are defined by device used
 *
 * \param[in] pull_mode Pin pull mode
 */
static inline void SS60_set_pull_mode(const enum port_pull_mode pull_mode)
{
	PORTD_set_pin_pull_mode(3, pull_mode);
}

/**
 * \brief Set SS60 data direction
 *
 * Select if the pin data direction is input, output or disabled.
 * If disabled state is not possible, this function throws an assert.
 *
 * \param[in] direction PORT_DIR_IN  = Data direction in
 *                      PORT_DIR_OUT = Data direction out
 *                      PORT_DIR_OFF = Disables the pin
 *                      (low power state)
 */
static inline void SS60_set_dir(const enum port_dir dir)
{
	PORTD_set_pin_dir(3, dir);
}

/**
 * \brief Set SS60 level
 *
 * Sets output level on a pin
 *
 * \param[in] level true  = Pin level set to "high" state
 *                  false = Pin level set to "low" state
 */
static inline void SS60_set_level(const bool level)
{
	PORTD_set_pin_level(3, level);
}

/**
 * \brief Toggle output level on SS60
 *
 * Toggle the pin level
 */
static inline void SS60_toggle_level()
{
	PORTD_toggle_pin_level(3);
}

/**
 * \brief Get level on SS60
 *
 * Reads the level on a pin
 */
static inline bool SS60_get_level()
{
	return PORTD_get_pin_level(3);
}

/**
 * \brief Set SS90 pull mode
 *
 * Configure pin to pull up, down or disable pull mode, supported pull
 * modes are defined by device used
 *
 * \param[in] pull_mode Pin pull mode
 */
static inline void SS90_set_pull_mode(const enum port_pull_mode pull_mode)
{
	PORTD_set_pin_pull_mode(4, pull_mode);
}

/**
 * \brief Set SS90 data direction
 *
 * Select if the pin data direction is input, output or disabled.
 * If disabled state is not possible, this function throws an assert.
 *
 * \param[in] direction PORT_DIR_IN  = Data direction in
 *                      PORT_DIR_OUT = Data direction out
 *                      PORT_DIR_OFF = Disables the pin
 *                      (low power state)
 */
static inline void SS90_set_dir(const enum port_dir dir)
{
	PORTD_set_pin_dir(4, dir);
}

/**
 * \brief Set SS90 level
 *
 * Sets output level on a pin
 *
 * \param[in] level true  = Pin level set to "high" state
 *                  false = Pin level set to "low" state
 */
static inline void SS90_set_level(const bool level)
{
	PORTD_set_pin_level(4, level);
}

/**
 * \brief Toggle output level on SS90
 *
 * Toggle the pin level
 */
static inline void SS90_toggle_level()
{
	PORTD_toggle_pin_level(4);
}

/**
 * \brief Get level on SS90
 *
 * Reads the level on a pin
 */
static inline bool SS90_get_level()
{
	return PORTD_get_pin_level(4);
}

/**
 * \brief Set SS120 pull mode
 *
 * Configure pin to pull up, down or disable pull mode, supported pull
 * modes are defined by device used
 *
 * \param[in] pull_mode Pin pull mode
 */
static inline void SS120_set_pull_mode(const enum port_pull_mode pull_mode)
{
	PORTD_set_pin_pull_mode(5, pull_mode);
}

/**
 * \brief Set SS120 data direction
 *
 * Select if the pin data direction is input, output or disabled.
 * If disabled state is not possible, this function throws an assert.
 *
 * \param[in] direction PORT_DIR_IN  = Data direction in
 *                      PORT_DIR_OUT = Data direction out
 *                      PORT_DIR_OFF = Disables the pin
 *                      (low power state)
 */
static inline void SS120_set_dir(const enum port_dir dir)
{
	PORTD_set_pin_dir(5, dir);
}

/**
 * \brief Set SS120 level
 *
 * Sets output level on a pin
 *
 * \param[in] level true  = Pin level set to "high" state
 *                  false = Pin level set to "low" state
 */
static inline void SS120_set_level(const bool level)
{
	PORTD_set_pin_level(5, level);
}

/**
 * \brief Toggle output level on SS120
 *
 * Toggle the pin level
 */
static inline void SS120_toggle_level()
{
	PORTD_toggle_pin_level(5);
}

/**
 * \brief Get level on SS120
 *
 * Reads the level on a pin
 */
static inline bool SS120_get_level()
{
	return PORTD_get_pin_level(5);
}

/**
 * \brief Set DIPSW1 pull mode
 *
 * Configure pin to pull up, down or disable pull mode, supported pull
 * modes are defined by device used
 *
 * \param[in] pull_mode Pin pull mode
 */
static inline void DIPSW1_set_pull_mode(const enum port_pull_mode pull_mode)
{
	PORTD_set_pin_pull_mode(6, pull_mode);
}

/**
 * \brief Set DIPSW1 data direction
 *
 * Select if the pin data direction is input, output or disabled.
 * If disabled state is not possible, this function throws an assert.
 *
 * \param[in] direction PORT_DIR_IN  = Data direction in
 *                      PORT_DIR_OUT = Data direction out
 *                      PORT_DIR_OFF = Disables the pin
 *                      (low power state)
 */
static inline void DIPSW1_set_dir(const enum port_dir dir)
{
	PORTD_set_pin_dir(6, dir);
}

/**
 * \brief Set DIPSW1 level
 *
 * Sets output level on a pin
 *
 * \param[in] level true  = Pin level set to "high" state
 *                  false = Pin level set to "low" state
 */
static inline void DIPSW1_set_level(const bool level)
{
	PORTD_set_pin_level(6, level);
}

/**
 * \brief Toggle output level on DIPSW1
 *
 * Toggle the pin level
 */
static inline void DIPSW1_toggle_level()
{
	PORTD_toggle_pin_level(6);
}

/**
 * \brief Get level on DIPSW1
 *
 * Reads the level on a pin
 */
static inline bool DIPSW1_get_level()
{
	return PORTD_get_pin_level(6);
}

/**
 * \brief Set DIPSW2 pull mode
 *
 * Configure pin to pull up, down or disable pull mode, supported pull
 * modes are defined by device used
 *
 * \param[in] pull_mode Pin pull mode
 */
static inline void DIPSW2_set_pull_mode(const enum port_pull_mode pull_mode)
{
	PORTD_set_pin_pull_mode(7, pull_mode);
}

/**
 * \brief Set DIPSW2 data direction
 *
 * Select if the pin data direction is input, output or disabled.
 * If disabled state is not possible, this function throws an assert.
 *
 * \param[in] direction PORT_DIR_IN  = Data direction in
 *                      PORT_DIR_OUT = Data direction out
 *                      PORT_DIR_OFF = Disables the pin
 *                      (low power state)
 */
static inline void DIPSW2_set_dir(const enum port_dir dir)
{
	PORTD_set_pin_dir(7, dir);
}

/**
 * \brief Set DIPSW2 level
 *
 * Sets output level on a pin
 *
 * \param[in] level true  = Pin level set to "high" state
 *                  false = Pin level set to "low" state
 */
static inline void DIPSW2_set_level(const bool level)
{
	PORTD_set_pin_level(7, level);
}

/**
 * \brief Toggle output level on DIPSW2
 *
 * Toggle the pin level
 */
static inline void DIPSW2_toggle_level()
{
	PORTD_toggle_pin_level(7);
}

/**
 * \brief Get level on DIPSW2
 *
 * Reads the level on a pin
 */
static inline bool DIPSW2_get_level()
{
	return PORTD_get_pin_level(7);
}

#endif /* ATMEL_START_PINS_H_INCLUDED */
